mcb30/xyzebra/doc/report/drawing_panda.jpg

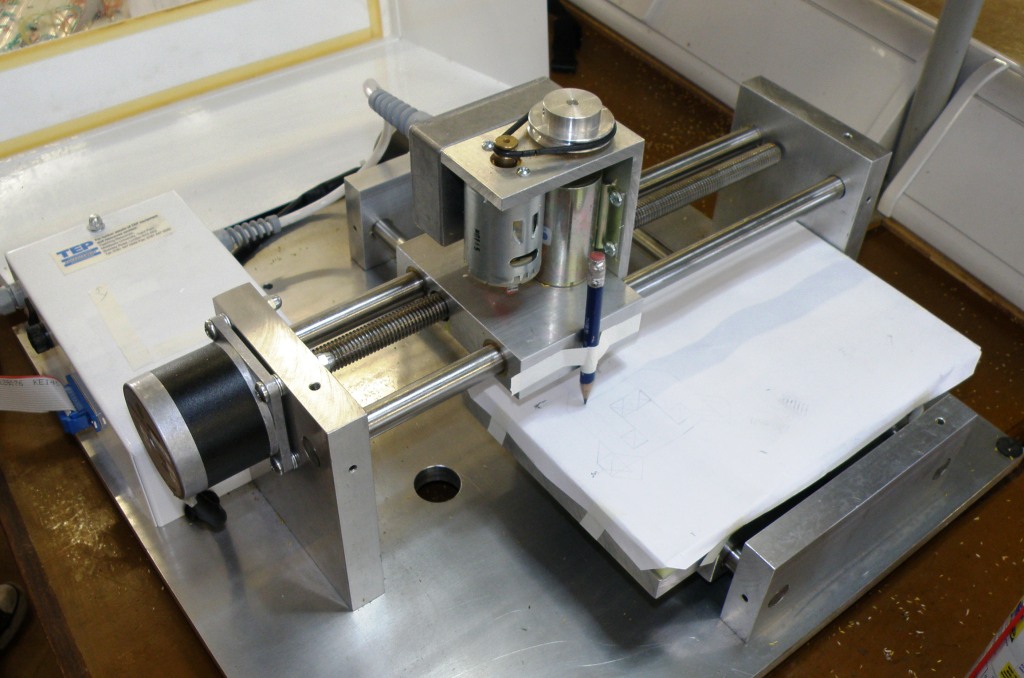
doc/report/drawing_panda.jpg
