mcb30/xyzebra/doc/report/Panda.jpg

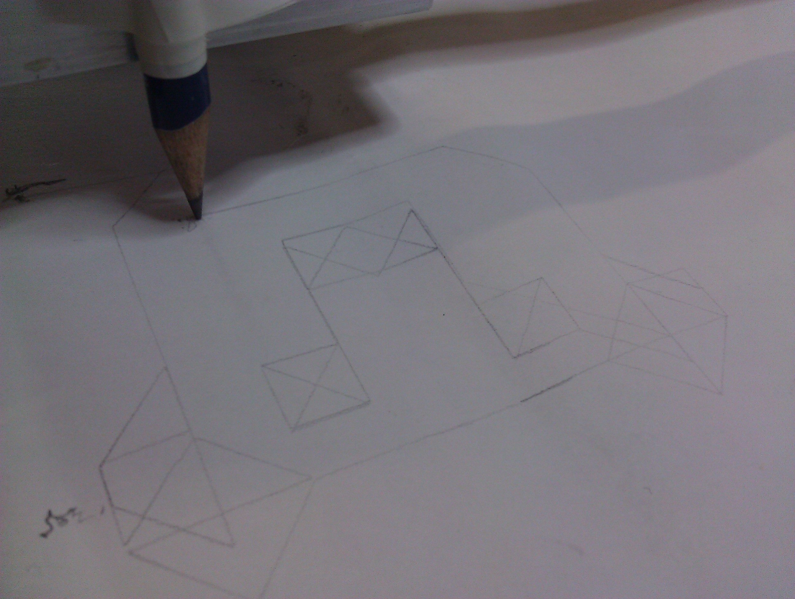
doc/report/Panda.jpg
