mcb30/xyzebra/doc/control_box_sketch_3d.png

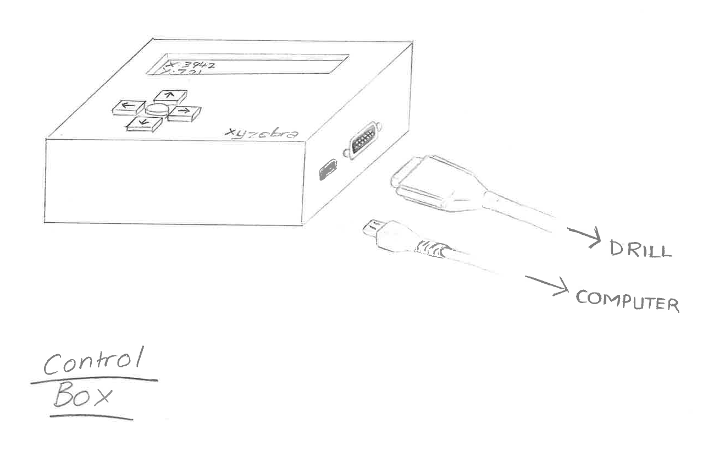
doc/control_box_sketch_3d.png
