mcb30/xyzebra/doc/control_box_sketch_top.png

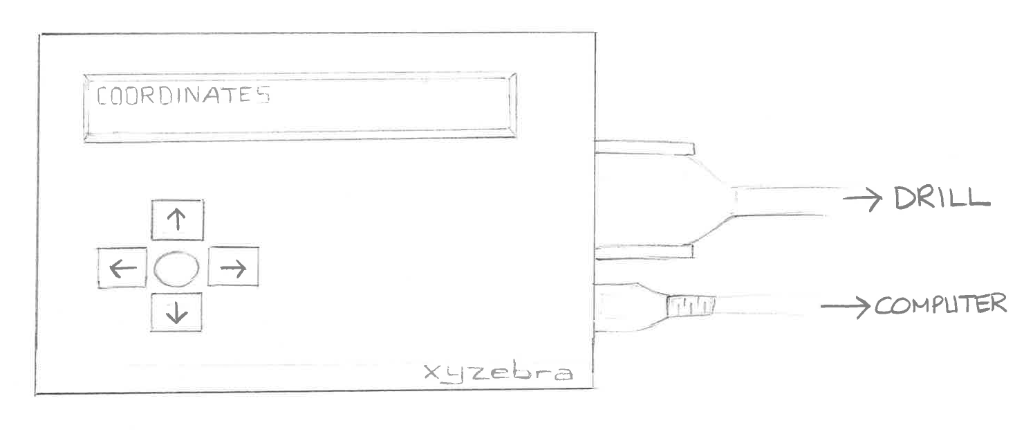
doc/control_box_sketch_top.png
