mcb30/xyzebra/doc/report/control_box_open.jpg

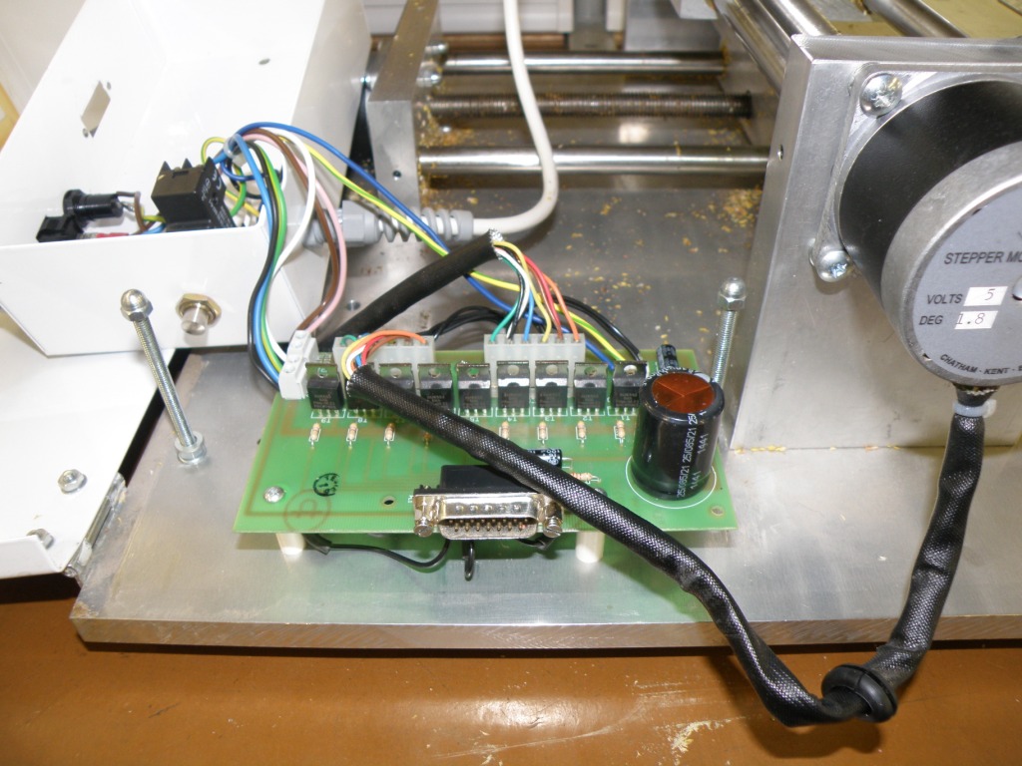
doc/report/control_box_open.jpg
