mcb30/xyzebra/doc/report/pcb1.jpg

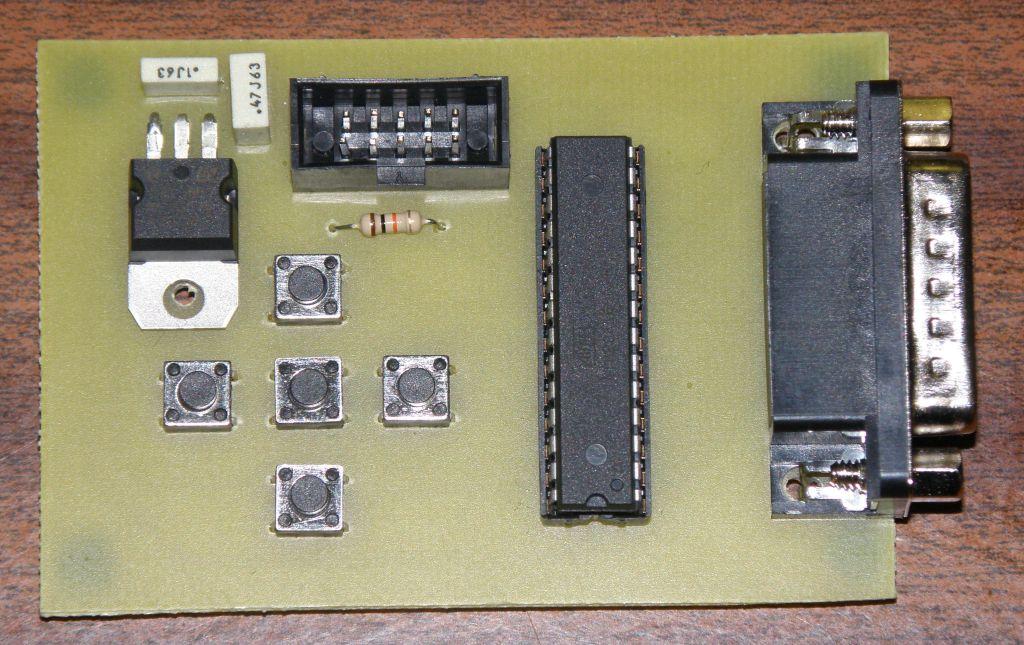
doc/report/pcb1.jpg
