mcb30/xyzebra/doc/report/pcb2.jpg

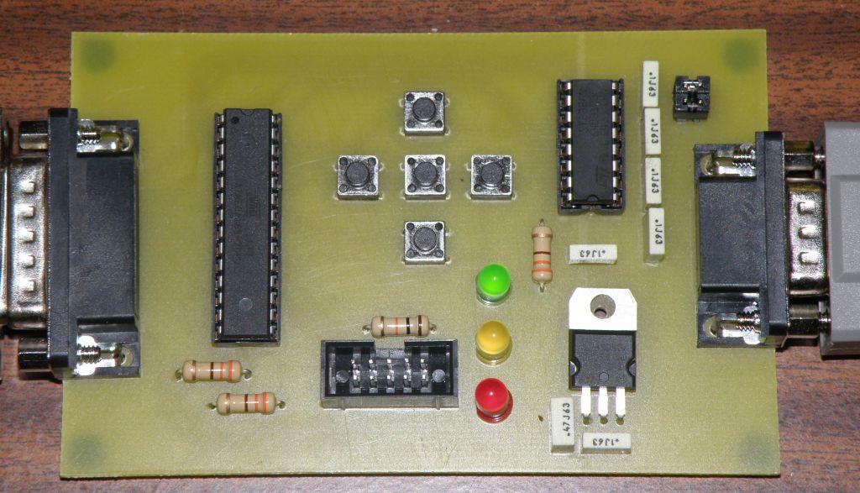
doc/report/pcb2.jpg
