mcb30/xyzebra/doc/report/rev_eng_bd_1.jpg

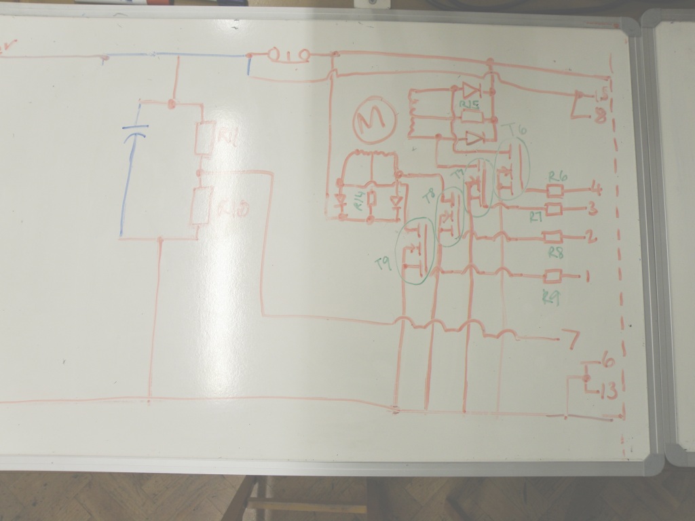
doc/report/rev_eng_bd_1.jpg
