mcb30/xyzebra/doc/report/rev_eng_bd_2.jpg

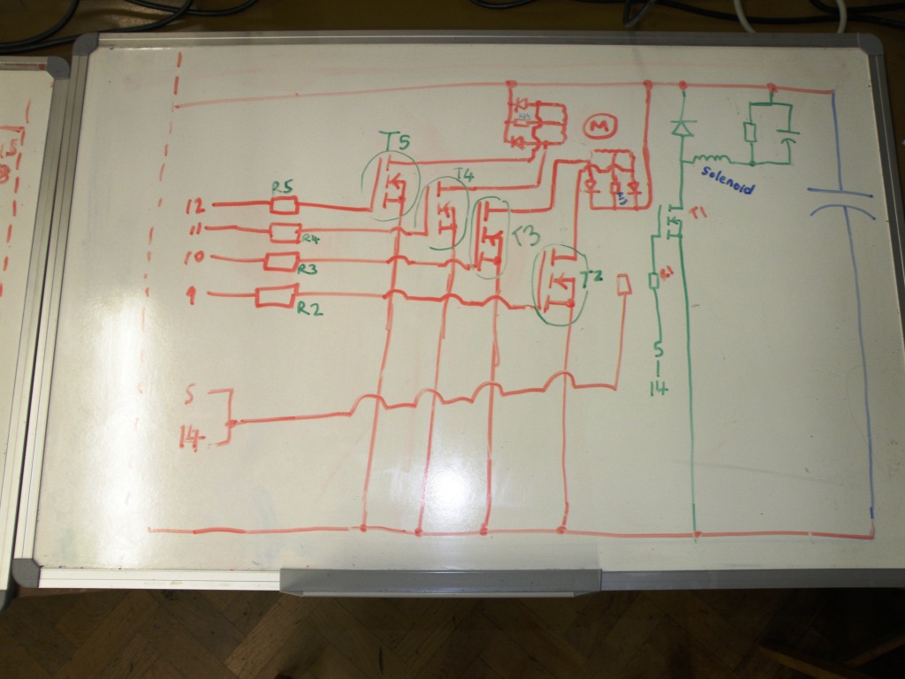
doc/report/rev_eng_bd_2.jpg
