mcb30/xyzebra/doc/report/stepper_motor.png

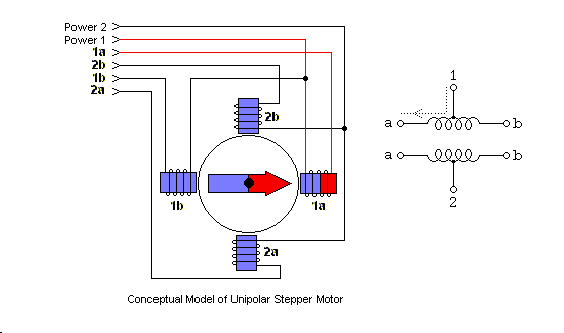
doc/report/stepper_motor.png
