mcb30/xyzebra/elec/XYcontroller.sch

## KiCad design elec/XYcontroller.sch (2012-04-25, an earlier design)

Schematic: XYcontroller.sch

Parts:
100: CP3
10000: CP2
D1, D2, D3, D4, D5, D6, D7, D8, D9: DIODE
L1: SOLENOID
L2, L3: X-STEPPER
L4, L5: Y-STEPPER
R1, R2, R3, R4, R5, R6, R7, R8, R9: 470
R10: 1k
R11: 2.2k
R12: R
R13, R14, R15, R16: 6.8
SW: SPST
T1, T2, T3, T4, T5, T6, T7, T8, T9: BUK553

Notes on the sheet:
AGC
0 V
12 V
