mcb30/xyzebra/elec/stepper_4017.sch

## KiCad design elec/stepper_4017.sch (2012-04-25, an earlier design)

Schematic: stepper_4017.sch

Parts:
C1: 1u
C2: 10n
R1: 10K
R2: 1K
R3, R4: 6.8
