mcb30/xyzebra/elec/tep_manual.sch

## KiCad design elec/tep_manual.sch (2012-02-01)

Schematic: tep_manual.sch

Parts:
C1: 100n; C2
C2: 330n; C2
P1: AVR-ISP-10; PIN_ARRAY_5x2
P2: DB15; DB15MC
R1: 10k; R4
SW1: FORWARD; SW_PUSH_6x6
SW2: LEFT; SW_PUSH_6x6
SW3: DRILL; SW_PUSH_6x6
SW4: RIGHT; SW_PUSH_6x6
SW5: BACKWARD; SW_PUSH_6x6
U1: L78S05CV; LM78XX
U2: ATMEGA168-P; DIP-28__300_ELL
