mcb30/xyzebra/elec/tep_rs232.sch

## KiCad design elec/tep_rs232.sch (2012-03-25)

Schematic: tep_rs232.sch

Parts:
C1, C3, C4, C5, C6, C7: 100n; C2
C2: 330n; C2
D1: RED; LED-5MM
D2: YELLOW; LED-5MM
D3: GREEN; LED-5MM
P1: AVR-ISP-10; PIN_ARRAY_5x2
P2: DB15; DB15MC
P3: DB9; DB9MC
R1: 10k; R4
R2, R3, R4: 330; R4
SW1: FORWARD; SW_PUSH_6x6
SW2: LEFT; SW_PUSH_6x6
SW3: DONE; SW_PUSH_6x6
SW4: RIGHT; SW_PUSH_6x6
SW5: BACKWARD; SW_PUSH_6x6
U1: L78S05CV; LM78XX
U2: ATMEGA168-P; DIP-28__300_ELL
U3: MAX232; DIP-16__300_ELL
