mcb30/xyzebra/(commit log)

2011-12-19 [elec] Create schematic from TEP CNC milling machine
    Create a schematic diagram of the controller inside the TEP CNC
    milling machine by reverse-engineering the PCB.
    Reverse-engineered-by: Philippa Woolley <pippa@xyzebra.co.uk>
    Reverse-engineered-by: Abigail Cox <pippa@xyzebra.co.uk>
    [tep_machine.sch]
2011-12-20 [misc] Fix incorrect file permissions
    Fix unintentionally executable files resulting from import via USB
    flash drive.
    [tep_machine.sch]
2011-12-20 [elec] Import component library
    Import component library from C programming tutorial, containing
    DLP-USB245R, LED matrix, and ULN2803A symbols.
2012-01-06 [src] Add sample AVR code
2012-01-25 [src] Adjust code to match new PCB layout
2012-02-01 [src] First working version of manual controller PCB
    Fixes:
    allow solenoid to be switched off as well as on
    change stepper motor sequence
    change AVR model to ATmega168
    [tepctrl.c]
2012-02-01 [elec] Add schematic and PCB for TEP manual controller
    [tep_manual.brd, tep_manual.sch]
2012-02-02 [elec] Ignore kicad autogenerated files
2012-02-02 [elec] Add RS232 port to TEP control board
    [tep_rs232.brd, tep_rs232.sch]
2012-02-03 [elec] Add DCE/DTE jumpers to allow for use of null-modem cable
    [tep_rs232.brd, tep_rs232.sch]
2012-02-03 [doc] Add RS-274X Extended Gerber Format specification document
    Downloaded from
    http://www.ucamco.com/public/RS-274X_Extended_Gerber_Format_Specification_201201.pdf
2012-02-04 [elec] Fix mounting hole placement and move switches closer to edge
    [tep_rs232.brd]
2012-02-19 [src] Updated cnc.c to drill out shape - still pencil.
    Can now move to co-ordinates and drill for multiple co-ords. Drill up
    at end.
2012-02-26 [src] Add functioning LED control and stub RS232 control
2012-03-14 [src] Clear error when button is released.
    [buttons.c]
2012-03-25 [src] Added manual drill command
2012-03-25 [elec] Updated circuit diagrams now with flow control
    [tep_rs232.brd, tep_rs232.sch]
2012-03-25 [src] Changed Solenoid and dril stays up in error state
    [cnc.c]
2012-03-27 [doc] Updated my parts for report. Have to add in circuits & flowcharts
2012-04-03 [src] Turned buttons flowchart into code
2012-04-08 [doc] added control flowchart EPS
2012-04-08 [doc] Added in flowchart and parts of relevent code
2012-04-08 [src] Added Target flowchart file
2012-04-08 [elec] Schem. for 4017 and stepper added
    [stepper_4017.sch]
2012-04-11 [src] Code updated to move to and print co-ordinates
    It will now print back everything in a shorter form, can handle
    everything except changing drillbits and will also move to co-ordinates.
    [serial.c]
2012-04-11 [src] Swapped solenoid up/down Signed-off-by: Charlie Blake <charlie@xyzebra.co.uk>
    [cnc.c]
2012-04-12 [doc] Merged initial report drafts into a single LyX document
    [stepper_4017.sch]
2012-04-12 [elec] Added stepper motor component for eeschema
    [XYcontroller.sch]
2012-04-12 [src] Used to drive the stepper motor
    Originally named ftdi3.c
2012-04-12 [src] Updated to definately reset to 0,0 Signed-off-by: Charlie Blake <charlie@xyzebra.co.uk>
    [dlpusb245_control.c]
2012-04-14 [doc] Added both proof of concept and interpreting drill files with relevant appendix entries Signed-off-by: Charlie Blake <charlie@xyzebra.co.uk>
2012-04-25 [doc] Added buttons, flowcharts, programming to the report.
2012-04-25 [src] Updated error checking Signed-off-by: Charlie Blake <charlie@xyzebra.co.uk>
    [serial.c]
2012-04-25 [doc] Fix up to and including 4017 control
    TODO: circuit diagram for 4017 is missing
2012-04-25 [doc] Fix up to and including end of "buttons" section
    TODO: missing flowchart graphics
2012-04-25 [src] Add flowcharts
2012-04-25 [doc] Add EPS versions of buttons flowcharts
2012-04-25 [doc] Add button flowcharts to report
2012-04-25 [elec] Neaten up reverse-engineered circuit layout
    [XYcontroller.sch]
2012-04-25 [doc] Fix up to and including CNC flowchart
2012-04-25 [doc] Add photos of PCBs
2012-04-25 [doc] Update EPS versions of final circuit diagrams
2012-04-25 [doc] Update EPS files for 4017 circuit
    [stepper_4017.sch]
2012-04-25 [doc] Add RS-232 flowchart
2012-04-25 [doc] Include RS-232 flowchart in report
2012-04-25 [doc] added neater version of targets flowchart (eps)
2012-04-25 [doc] Added neater Targets flowchart (odg)
2012-04-25 [doc] Fixed straight lines in buttons flowchart
2012-04-25 [doc] Update EPS for buttons flowchart
